kevinrefermat/AutonomousRover/experimental/positioning-system/SonarReceiverSchematic.jpeg

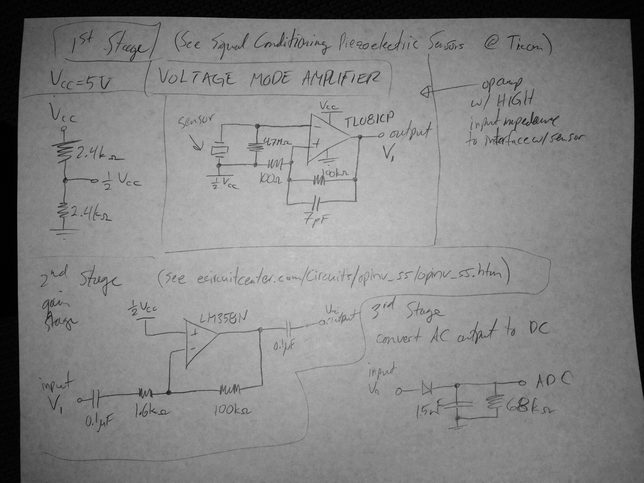
experimental/positioning-system/SonarReceiverSchematic.jpeg
