kevinrefermat/AutonomousRover/photos/timer-prescaler-calculations.jpg

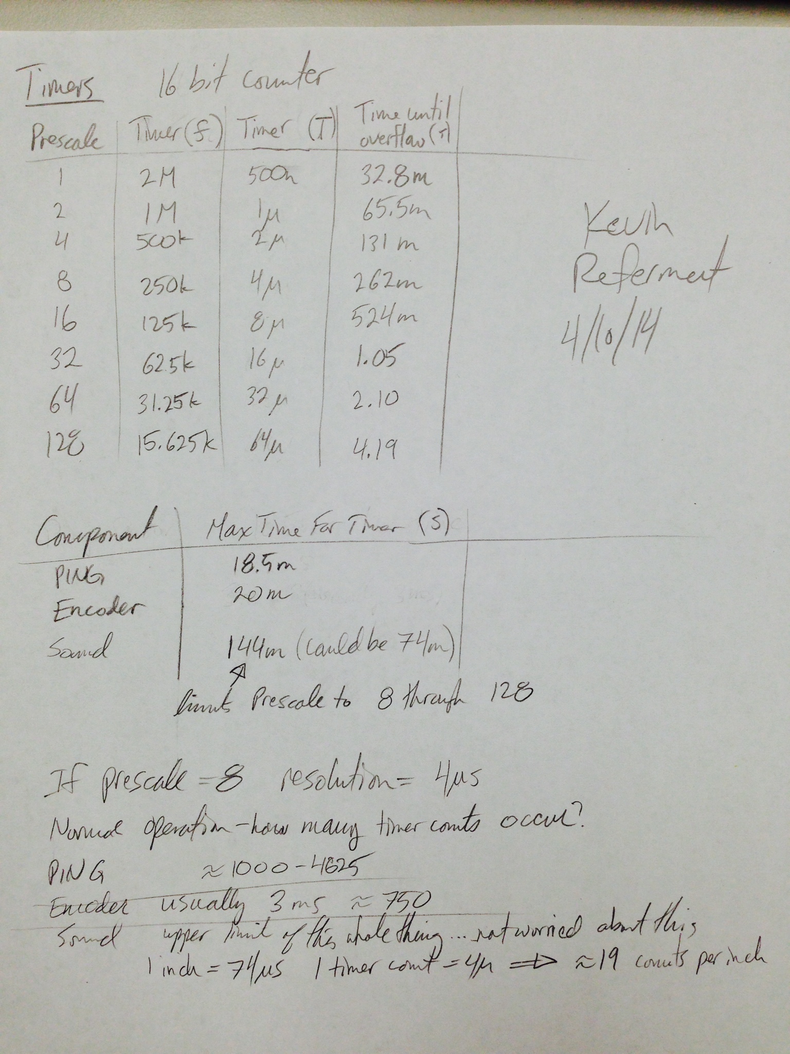
photos/timer-prescaler-calculations.jpg
