kevinrefermat/AutonomousRover/photos/environment-floor-plan.jpg

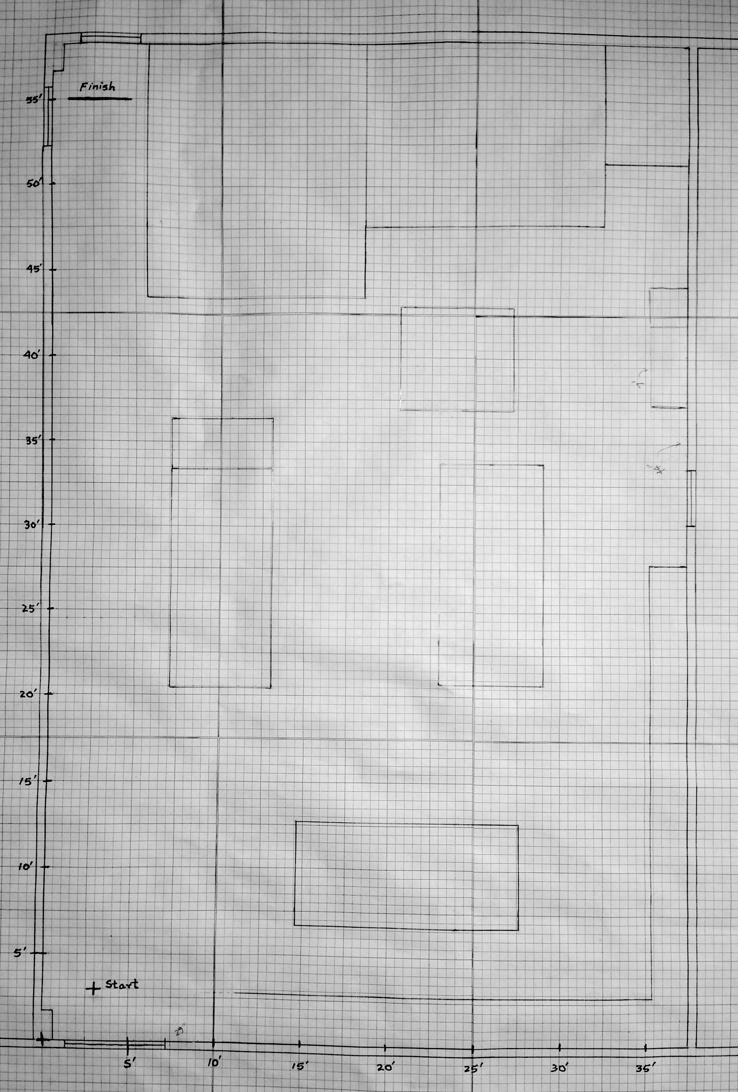
photos/environment-floor-plan.jpg
