kevinrefermat/AutonomousRover/photos/main-run-loop-algorithm.png

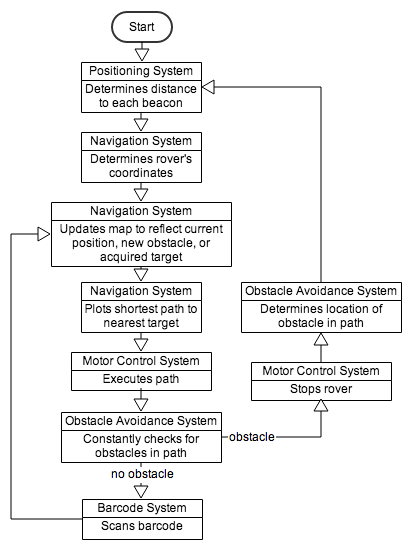
photos/main-run-loop-algorithm.png
