kevinrefermat/AutonomousRover/photos/rover.jpg

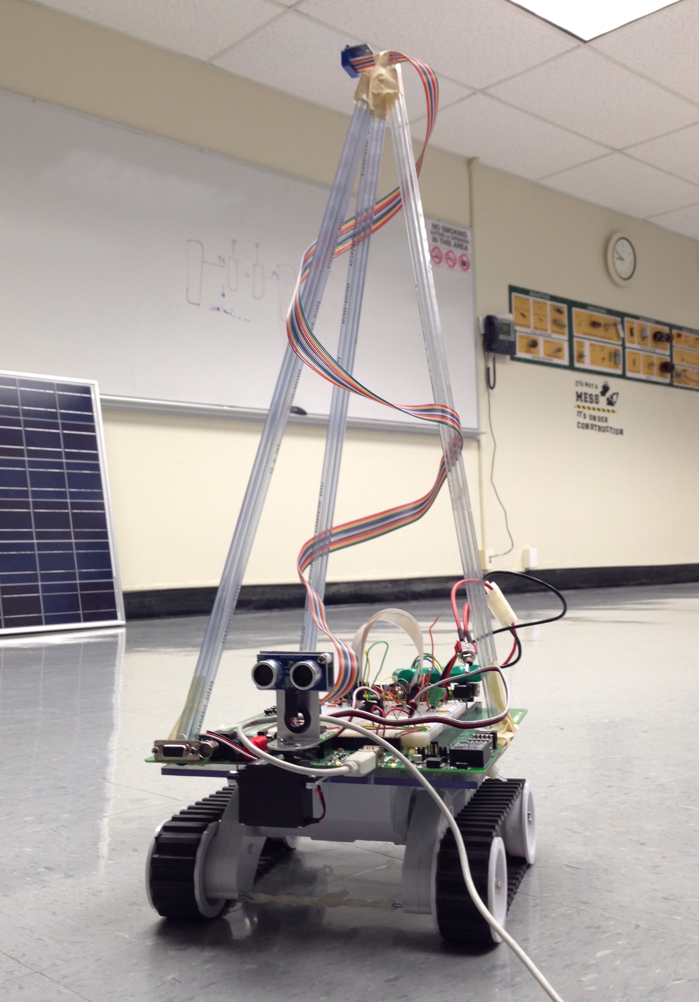
photos/rover.jpg
