kevinrefermat/AutonomousRover/photos/speed-of-sound-plot.png

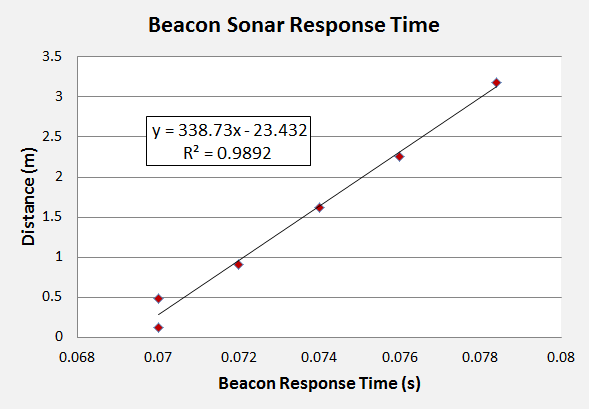
photos/speed-of-sound-plot.png
