kevinrefermat/AutonomousRover/experimental/positioning-system/SpeedOfSoundProof.xlsx

speed of sound | 13.3972 | inches/ms
 |  | distance (in) | distance (m) | time (ms) | time (s)
 |  | 5 | 0.127 | 70 | 0.07
 |  | 19 | 0.4826 | 70 | 0.07
 |  | 36 | 0.9144 | 72 | 0.072
 |  | 64 | 1.6256 | 74 | 0.074
 |  | 89 | 2.2606 | 76 | 0.076
 |  | 125 | 3.175 | 78.4 | 0.0784
 |  |  |  | 87.2
 |  |  |  |  |  | v
