kevinrefermat/AutonomousRover/experimental/motor-control-system/pulseDifferentialCircuit.png

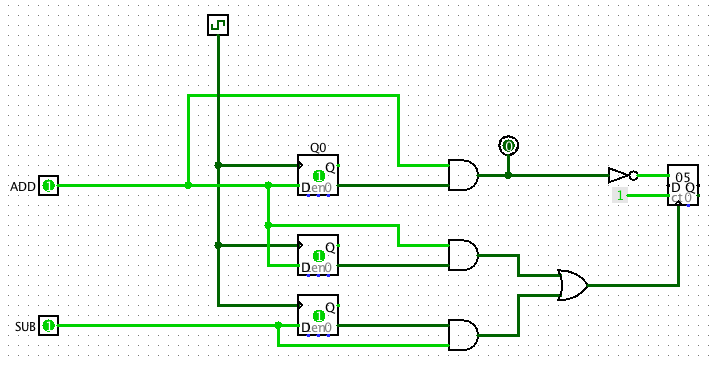
experimental/motor-control-system/pulseDifferentialCircuit.png
