kevinrefermat/AutonomousRover/experimental/navigation-system/MiscellaneousNavigationPracticeFiles/navigationC/Graph1.png

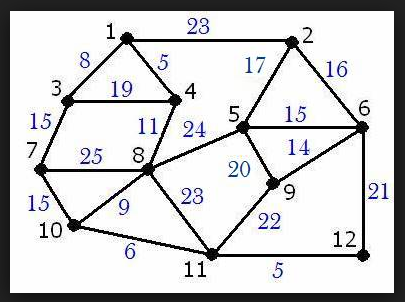
experimental/navigation-system/MiscellaneousNavigationPracticeFiles/navigationC/Graph1.png
