kevinrefermat/AutonomousRover/photos/navigation-system-ascii-test-map.png

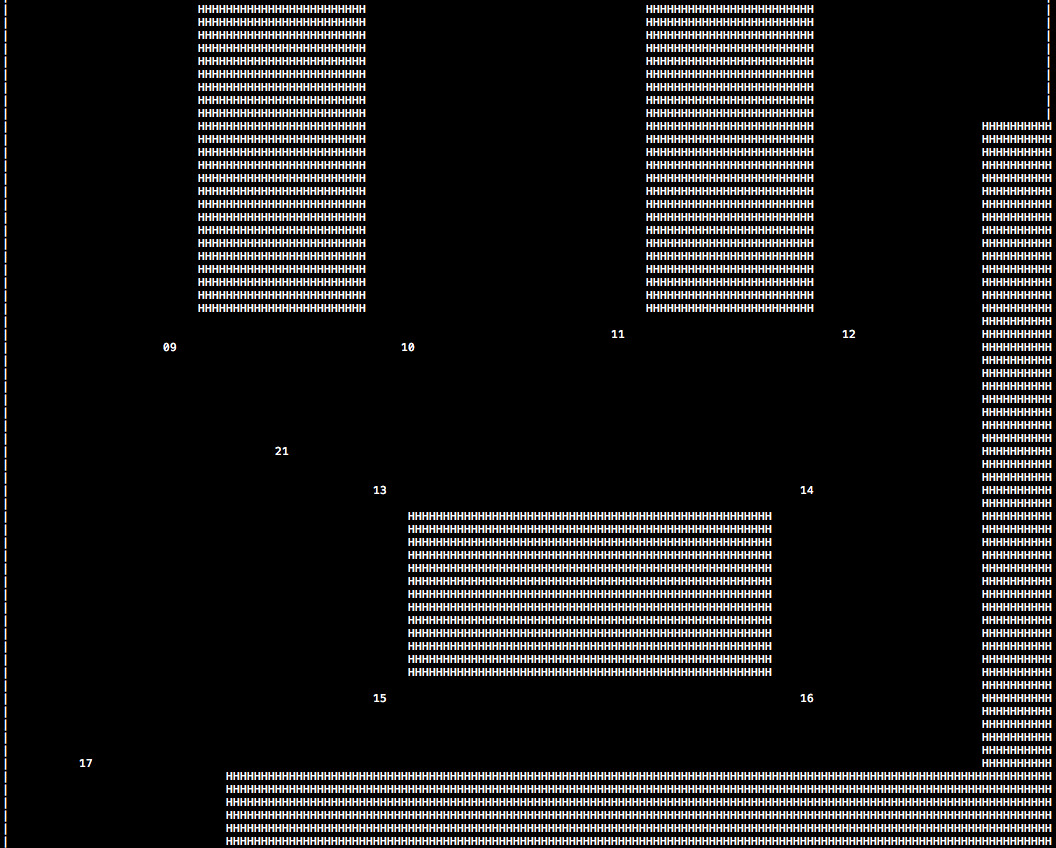
photos/navigation-system-ascii-test-map.png
