kevinrefermat/AutonomousRover/(list of files, drawings)

Other design files:
experimental/motor-control-system/pulseDifferentialCircuit.circ
experimental/positioning-system/instrumentation amplifer 2.ms12
experimental/positioning-system/instrumentation amplifer.ms12
experimental/positioning-system/JohnReceiverCirucit.ms12
experimental/positioning-system/Preset Circuit.ms12
experimental/positioning-system/SonarAmplifierAndDetector.ms12
experimental/positioning-system/ULTRA rect.ms12
