kevinrefermat/AutonomousRover/project-files/src/Compass.c

#include "I2C.h"
#include "Rover.h"
#include "Compass.h"

static const Byte SettingsCRA = 0x7C; // 0x10 default
static const Byte SettingsCRB = 0x40; // 0x20 default
static const Byte SettingsMode = 0x00; // 0x00 default

static const Byte AddressCRA = 0x00;
static const Byte AddressCRB = 0x01;
static const Byte AddressMode = 0x02;

static const Byte SlaveWrite = 0x3C;
static const Byte SlaveRead = 0x3D;

static sWord xShiftValue = -16;
static sWord yShiftValue = 123;
static sWord yScaleValueNumerator = 7;
static sWord yScaleValueDenominator = 100;

static const boolean_t NACK = TRUE;

static const Byte MaxNumberOfFailedAttempts = 10;
static const degree_t MaxTolerableDifferenceBetweenTwoConsecutiveCompassReadings = 2;

static fullCompassRegister_t rawXData;
static fullCompassRegister_t rawYData;
static fullCompassRegister_t rawZData;

boolean_t writeByteToCompass( boolean_t sendStart, boolean_t sendStop, Byte data )
{
   Byte numberOfFailedAttempts = 0;
   while ( I2CWriteByte( sendStart, sendStop, data ) == TRUE ) // I2CWriteByte returned nack = 1
   {  
      numberOfFailedAttempts++;
      if ( numberOfFailedAttempts == MaxNumberOfFailedAttempts )
      {
         TurnOnErrorLight();
         return 1; // nack = 1
      }
   } 
   return 0; // nack = 0
}

boolean_t InitializeCompass()
{
   if ( writeByteToCompass( 1, 0, SlaveWrite ) == NACK ) return FALSE;
   if ( writeByteToCompass( 0, 0, AddressCRA ) == NACK ) return FALSE;
   if ( writeByteToCompass( 0, 1, SettingsCRA ) == NACK ) return FALSE;
   
   if ( writeByteToCompass( 1, 0, SlaveWrite ) == NACK ) return FALSE;
   if ( writeByteToCompass( 0, 0, AddressCRB ) == NACK ) return FALSE;
   if ( writeByteToCompass( 0, 1, SettingsCRB ) == NACK ) return FALSE;
   
   if ( writeByteToCompass( 1, 0, SlaveWrite ) == NACK ) return FALSE;
   if ( writeByteToCompass( 0, 0, AddressMode ) == NACK ) return FALSE;
   if ( writeByteToCompass( 0, 1, SettingsMode ) == NACK ) return FALSE;
   
   return TRUE;
}

Byte readByteFromCompass( boolean_t sendStop )
{
   return I2CReadByte( FALSE, sendStop ); // send nack = 0 as the response byte
}

void CalibrateCompass()
{     
   sWord i, minX, maxX, minY, maxY;
   TurnOnErrorLight();
   GetDataFromCompass();
   minX = rawXData.value;
   maxX = minX;
   minY = rawYData.value;
   maxY = minY;
   
   for ( i = 0; i < 1000; i++ )
   {
      GetDataFromCompass();
      if ( rawXData.value < minX ) minX = rawXData.value;
      if ( rawXData.value > maxX ) maxX = rawXData.value;
      if ( rawYData.value < minY ) minY = rawYData.value;
      if ( rawYData.value > maxY ) maxY = rawYData.value;
   }
   
   TurnOffErrorLight();
   
   xShiftValue = -( maxX + minX ) / 2;
   yShiftValue = -( maxY + minY ) / 2;
   yScaleValueNumerator = ( 10 * ( maxX - minX ) / 2 ) % ( ( maxY - minY ) / 2 / 10 );
   yScaleValueDenominator = 100;
}

// returns 1 on success and 0 on failure
boolean_t GetDataFromCompass()
{
   if ( writeByteToCompass( 1, 0, SlaveRead ) == NACK ) return FALSE;
   
   rawXData.bytes.upper = readByteFromCompass( 0 );
   rawXData.bytes.lower = readByteFromCompass( 0 );
   rawZData.bytes.upper = readByteFromCompass( 0 );
   rawZData.bytes.lower = readByteFromCompass( 0 );
   rawYData.bytes.upper = readByteFromCompass( 0 );
   rawYData.bytes.lower = readByteFromCompass( 1 );
   
   // Make sure register pointer is at first register by writing nothing to it
   if ( writeByteToCompass( 1, 0, SlaveWrite ) == NACK ) return FALSE;
   if ( writeByteToCompass( 0, 1, 0x03 ) == NACK ) return FALSE;
   
   return TRUE;
}

// returns calculated bearing compared to magnetic north
degree_t GetASingleCompassReading()
{
   degree_t angle;
   sWord balancedX, balancedY;
   
   GetDataFromCompass();
   balancedX = rawXData.value + xShiftValue;
   balancedY = rawYData.value + yShiftValue;
   balancedY = balancedY + ( balancedY * yScaleValueNumerator ) / yScaleValueDenominator;
   
   angle = arcTangent( balancedY, balancedX );
   
   if ( angle < 0 ) angle += 360;
   return angle;
}

// takes two back to back measurements and returns angle on success or -1 on failure.
degree_t GetAnAccurateCompassReading()
{
   degree_t reading1, reading2, difference1And2;
   reading1 = GetASingleCompassReading();
   reading2 = GetASingleCompassReading();
   
   difference1And2 = reading1 - reading2;
   
   //absolute value
   difference1And2 = difference1And2 > 0 ? difference1And2 : -difference1And2;
   
   if ( difference1And2 <= MaxTolerableDifferenceBetweenTwoConsecutiveCompassReadings ||
        difference1And2 >= 360 - MaxTolerableDifferenceBetweenTwoConsecutiveCompassReadings ) // for reading1 = 358 and reading2 = 0
   {
      //return the more current measurement
      return reading2;
   }
   return -1;
}
