kevinrefermat/AutonomousRover/project-files/src/NavigationSystem.h

#ifndef _NAVIGATION_SYSTEM_H_
#define _NAVIGATION_SYSTEM_H_

#include "Rover.h"

/*** TYPE DEFINITIONS ***/

typedef struct
{
   coordinates_t leftPoint;
   coordinates_t rightPoint;
} segment_t;

typedef struct
{
   inches_t left;
   inches_t right;
   inches_t top;
   inches_t bottom;
} tetragon_t;

typedef struct
{
   direction_t typeOfMotion;
   sWord value;
} turnByTurnElement_t;

typedef struct
{
   coordinates_t coordinates;
   coordinates_t accessPoint[ 4 ];
   nodeNumber_t numberOfAccessPoints;
} target_t;

typedef struct
{
   nodeNumber_t startingAccessPointNodeNumber;
   nodeNumber_t numberOfAccessPoints;   
} runtimeTarget_t;

/*** FUNCTIONS ***/

void InitializeNavigationSystem( nodeNumber_t * pTargetNodes );

void AddNode( inches_t x, inches_t y );
void AddObstacle( inches_t left, inches_t right, inches_t top, inches_t bottom );
void SetRoversPosition( inches_t x, inches_t y );   
void SetRoversBearing( degree_t degrees );
coordinates_t GetRoversPosition( void );
degree_t GetRoversBearing( void );
nodeNumber_t GetRoversNodeId( void );

inches_t Dijkstra( nodeNumber_t sourceNodeId, nodeNumber_t targetNodeId );

void UpdateSingleNodeConnections( nodeNumber_t node );
void UpdateAllNodeConnections( void );

boolean_t NodesAreVisibleToEachOther( nodeNumber_t nodeId1, nodeNumber_t nodeId2 );
static boolean_t IntersectWithObstacle( segment_t* segment );
static boolean_t IntersectWithShape( tetragon_t* tetragon, segment_t* segment );
static boolean_t IntersectWithSegment( segment_t* segment0, segment_t* segment1 );
static boolean_t IsAbove( segment_t* segment, coordinates_t* point );

static void SetAdjacencyMatrixValue( nodeNumber_t row, nodeNumber_t column, inches_t value );
static inches_t GetAdjacencyMatrixValue( nodeNumber_t row, nodeNumber_t column );

void UpdateTurnByTurnQueueFromNodeSequence( void );

coordinates_t* GetNodeCoordinates( nodeNumber_t nodeId );

turnByTurnElement_t* GetNextTurnByTurnElement( void );
boolean_t HasNextTurnByTurnElement( void );

nodeNumber_t GetClosestNodeForTarget( nodeNumber_t sourceNodeId, nodeNumber_t runtimeTargetIndex );

nextState_t FindNextTarget( Byte *pNextTargetIndex );


#endif
