kevinrefermat/AutonomousRover/project-files/src/Math.h

#ifndef _MATH_H_
#define _MATH_H_

#include "Rover.h"

degree_t arcTangent( inches_t y, inches_t x );
inches_t Distance( coordinates_t A, coordinates_t B );
inches_t SquareRoot( sLWord operand );
Word abs16( sWord operand );

#endif
