kevinrefermat/AutonomousRover/project-files/src/Compass.h

#include "I2C.h"
#include "Rover.h"

typedef union
{
   sWord value;
   struct compassRegisters
   {
      Byte upper;
      Byte lower;
   } bytes;
} fullCompassRegister_t;

boolean_t InitializeCompass( void );
degree_t GetAnAccurateCompassReading( void );
boolean_t GetDataFromCompass( void );

boolean_t writeByteToCompass( Byte register, Byte data );
Byte readByteFromCompass( boolean_t sendStop );
