kevinrefermat/AutonomousRover/experimental/navigation-system/NavigationSystemPractice/MockRover.h

#ifndef _MOCK_ROVER_H_
#define _MOCK_ROVER_H_

#include <stdint.h>

typedef uint8_t Byte;
typedef int8_t sByte;
typedef uint16_t Word;
typedef int16_t sWord;
typedef uint32_t LWord;
typedef int32_t sLWord;

typedef int16_t inches_t;
typedef int16_t degree_t;

typedef uint8_t boolean_t;

extern const boolean_t True;
extern const boolean_t False;

#endif
