kevinrefermat/AutonomousRover/(commit log)

2014-01-24 Compiles fine; main and motor control
2014-02-05 Added modularity to MotorControl
2014-02-08 Implemented Ping))) and delay for motors. All works
2014-02-11 fixed it's brokeness. restored to the condition it was in night before faculty review
    [ObstacleAvoidanceSystem.c, ObstacleAvoidanceSystem.h, P&E_Multilink_USB.ini, Rover.c, Rover.h, grid.c]
2014-02-13 work done in lab but didn't push to master. pushing days later
    [ObstacleAvoidanceSystem.h, P&E_Multilink_USB.ini, Rover.c]
2014-02-14 added a timer to Graph.c to clock it
2014-02-20 testing and changes made to Tx program
    [Preset Circuit.ms12]
2014-02-26 updated multisim circuit for analog beacon selection
    [Preset Circuit.ms12]
2014-02-27 Implemented eelab print, nodeSequence, nodeSequenceDistances, still needs sine and cosine and degree functionality
2014-02-27 Added MockRover.h to avoid sytanx changes between platforms
    [MockRover.h, NavigationSystem.c, NavigationSystem.h, main.c]
2014-02-28 Last commit before spring break. dijkstra nav + output distance works
2014-02-28 Reorganized root folder
    [Preset Circuit.ms12]
2014-03-20 made periodic ping interrupt call function. changed obstcale avoidance functions from camel to pascal
    [MotorControlSystem.c, MotorControlSystem.h, ObstacleAvoidanceSystem.c, ObstacleAvoidanceSystem.h, Rover.c, Rover.h, main.c]
2014-03-21 Variable motor speed works. periodic PING works. setPingDirection works. success.
2014-03-25 Tested power control
2014-03-26 Added pulse differential circuit logisim file and png of schematic
    [pulseDifferentialCircuit.circ]
2014-04-01 added pulse circuit and main practice folder
    [pulseDifferentialCircuit.circ]
2014-04-03 updated in lab today to get battery fixed
    [SpeedOfSoundProof.xlsx]
2014-04-03 fixed periodic detection functions but still need to change the functions in the headers. also removed some of the timer settings from the global call of initializeTimers()
    [ObstacleAvoidanceSystem.c, Rover.c]
2014-04-03 Messed with the timer clock. Maybe it can be a lot slower to allow for longer periods of interrupts
2014-04-03 Cleaned Up and refactored MCS and OAS. Also converted some constants to DEFINES. Added TIMER_PRESCALE functionality to automatically set the prescale in TSCR2.
2014-04-04 Verified software from a non hardware coding day. Working with motor stabilizer.
2014-04-08 progress with implementing compass module and i2c controller
2014-04-09 I2C corrections made, hopefully it works now
    [Compass.h, I2C.c, I2C.h, MotorControlSystem.c, P&E_Multilink_USB.ini, Rover.c, compass.c, main.c]
2014-04-10 Added algorithm for motor control
2014-04-11 Motor stabilization works but not well
2014-04-13 Attempted to implement PID controller
2014-04-15 MUST CALIBRATE COMPASS EVERY TIME but it finally fucking works with Rotate
    [RotateTest.xlsx]
2014-04-17 Added speed of sound plot and spreadsheet
    [SpeedOfSoundProof.xlsx]
2014-04-23 circuit schematics
    [SonarAmplifierAndDetector.ms12, instrumentation amplifer 2.ms12, instrumentation amplifer.ms12]
2014-04-25 Added timeouts to positioning system software. Changed threshhold detection in positioning system
    [OnRoverSoundProof.xlsx]
2014-04-25 Added Sonar receiver schematic
2014-04-30 Made triangulation system better. Added johns circuit.
    [JohnReceiverCirucit.ms12, ULTRA rect.ms12]
2014-04-30 Changed sonar detection setting to wait THEN sample noise THEN detect signal
    [PositioningSystem.c, PositioningSystem.h, main.c]
2014-05-01 Tested receiver and it works now using the minimum instead of the maximum. I lengthened the noise detector so i may have to make sure that the delay isn't too large before detection. I still need to 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
    [ObstacleAvoidanceSystem.c, PositioningSystem.c, Rover.h, main.c]
2014-05-01 Changed names of files to quicken accesses to RoverTeamTwo/
    [CompassRotateTest.xlsx]
2016-03-23 cleaned up
    [CompassRotateTest.xlsx, JohnReceiverCirucit.ms12, OnRoverSoundProof.xlsx, Preset Circuit.ms12, SonarAmplifierAndDetector.ms12, SpeedOfSoundProof.xlsx, ULTRA rect.ms12, instrumentation amplifer 2.ms12]
